a1k0n/tt08-vga-donut/docs/info.md

<!---

This file is used to generate your project datasheet. Please fill in the information below and delete any unused
sections.

You can also include images in this folder and reference them in the markdown. Each image must be less than
512 kb in size, and the combined size of all images must be less than 1 MB.
-->

# VGA Donut

preview

## How it works

Renders a faceted donut to a VGA monitor.  A much more detailed breakdown is
available [on my blog](https://www.a1k0n.net/2025/01/10/tiny-tapeout-donut.html).

Like my other demo on tt08, this runs in a weird VGA resolution: 1220x480, but
still 4:3 aspect ratio like 640x480.

Interestingly, it is not actually rendering any polygons; this is sphere traced
(AKA raymarched), using a CORDIC unit to calculate the distance between a point
and the surface of the torus. But, because we don't have much time (we're racing
the VGA beam!), we do just two or three CORDIC iterations, which causes the
donut surface to actually become polyhedral. This trick was [accidentally
discovered by Bruno Levy](https://x.com/BrunoLevy01/status/1718674786954399798)
while playing with a C version of my original donut code and I had to try it out
in Verilog -- so here we are.

The reason it has such low horizontal resolution is because it's doing 16 ray
marching steps per "pixel", with five CORDIC iterations unrolled into one clock
cycle (three iterations for the major axis, and two for the minor axis).

In order to fit this into 2x2 TinyTapeout tiles, a lot of sacrifices were made;
for one, it doesn't have a multiplier so the ray steps are by approximate orders
of magnitude. New donut "pixels" are rendered every 16 clock cycles, so the demo
makes heavy use of dithering in both space and time -- the video looks much
better than the screenshot above.

## How to test

Connect VGA Pmod to output, set clock to 48MHz, and give it a reset pulse.

## External hardware

[TinyVGA Pmod](https://github.com/mole99/tiny-vga) for video on o[7:0].
