a1k0n/tt08-vga-donut/(commit log)

2024-08-30 3x real multipliers, fix off-by-one, better palette, fpga ver
    fixes some major wonkiness, uses up 95% area but appears to harden okay
    at this density.
    [demo_orangecrab.v, donut.c, donut.v, donuthit.v, tt_um_a1k0n_vgadonut.v]
2024-08-31 moar dithering; fix our approx multiply unit and get rid of *s
    this should save a lot of gate area and it looks better, too. had to do
    a silily hack to prevent holes in the raymarching but whatever works.
    i tried to get a 3-cordic iteration version and it looks *much* better
    but it doesn't meet timing and it doesn't fit :(
    [cordic2step.v, donut.v, donuthit.v, vgadonut.v]
2024-08-31 add more polygons! this donut looks much better.
    optimized the cordics, inserted a 3rd cordic step into one of the planes
    (so a total of 5 steps)... it *really* looks good if we can do 3 cordic
    steps in both planes, but i can't get it to meet the frequency target
    with that much comb logic.
2024-09-02 fix temporal dithering to be less jittery
    [donut.v]
2024-09-02 fix distorted projection when running for a long time
    [donut.v]
2024-09-02 fix broken dithering matrix
    [donut.v, vgadonut.v]
2024-09-05 FINALLY FIX DITHERING ARGH
    [vgadonut.v]
2025-01-14 update preview; save frames @ 60fps in verilator
    previous preview was too dark because of a bug in dithering I didn't
    discover until the last second before the deadline.
